zglowacz9/Manipulator-z-elektromagnesem/hardware_pcb/Schemat blokowy.png

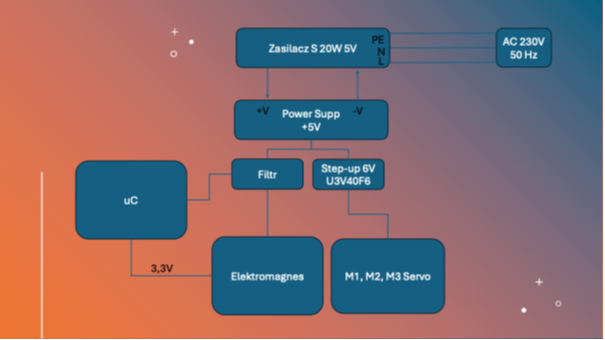
hardware_pcb/Schemat blokowy.png
