zglowacz9/Manipulator-z-elektromagnesem/hardware_pcb/Symulacja w programie LtSpiece.png

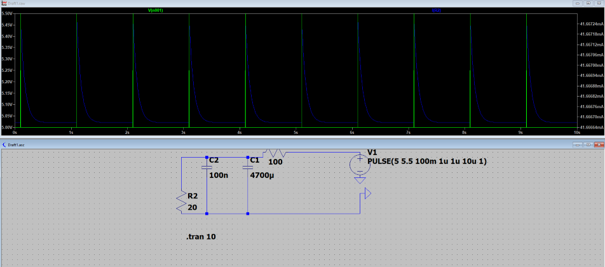
hardware_pcb/Symulacja w programie LtSpiece.png
