zglowacz9/Manipulator-z-elektromagnesem/hardware_pcb/Wizualizacja płytki.png

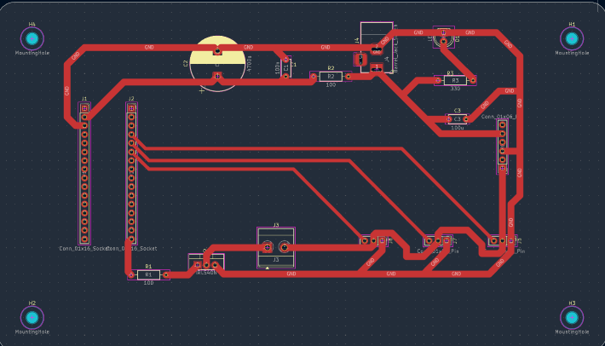
hardware_pcb/Wizualizacja płytki.png
