zglowacz9/Manipulator-z-elektromagnesem/(list of files, cad)

Other CAD files:
mechanical_3d/CZLON_1.prt
mechanical_3d/CZLON_2.prt
mechanical_3d/CZLON_3.prt
mechanical_3d/PODSTAWA.prt
mechanical_3d/ZLOZENIE.prt
